cvy7/ExpressLRS/PCB/900MHz/RX30dbm_20x20_0805_SMD/README.md

# 20x38 RX30dbm PCB

  

## Features

 * 20x38 footprint
 * 0805 size SMD components (for easy soldering) - NOTE: LED is still 0603 as this size is more common in LEDs
 * Components are placed for ease of soldering (easy iron access)
 * u.fl antenna connector footprint for 915MHz antenna
 * PCB trace antenna for WiFi
 * 5V input 
 * RFM95PW-868S2 with Output power +27dBm

## Editing

 * The PCB has been developed in Eagle, and the custom libraries that were used are attached in the /lib directory. Copy the project files into you Eagle project dir, and the libs into your lib dir, then fire up Eagle and edit.

 ## Ordering

 * I've had good results using JLCPCB (https://jlcpcb.com/). Upload the .zip file in this repo and adjust any PCB parameters that you want (defaults work fine).
 * A super-lightweight build can be achieved by going to a 0.6mm PCB thickness (without an increase to cost)
