cvy7/ExpressLRS/PCB/900MHz/RX30dbm_20x20_0805_SMD/BOM.xlsx

Designator | Footprint | Value | Description | Link
u.fl | u.fl |  | u.fl antenna connector | https://au.rs-online.com/web/p/ufl-connectors/1440895/
button | 3x6x2.5 |  | Tactile button | https://www.ebay.com.au/itm/10pcs-3-6-2-5mm-Tactile-Push-Button-Switch-Tact-Switch-Micro-Switch-2-Pin-SMD/282930653324
D1 | 0603 |  | LED
RFM96PW |  |  | RF module | https://www.aliexpress.com/item/32811523237.html
C1 | 3528 | 10uF | Tantalum Capacitor
C2 | 3528 | 100uF | Tantalum Capacitor
R1 | 0805 | 10K | Resistor
R2 | 0805 | 10K | Resistor
R3 | 0805 | 330R | Resistor
R4 | 0805 | 270R | Resistor
 | SOT22 | AMS1117 3.3 | 3.3V reg | https://www.aliexpress.com/item/32910803907.html?s=p
ESP-01F |  |  | ESP8266 module | https://www.aliexpress.com/item/32921798906.html
