cvy7/ExpressLRS/PCB/900MHz/RX30dbm_20x20_0805_SMD/project/rx_bot.pdf

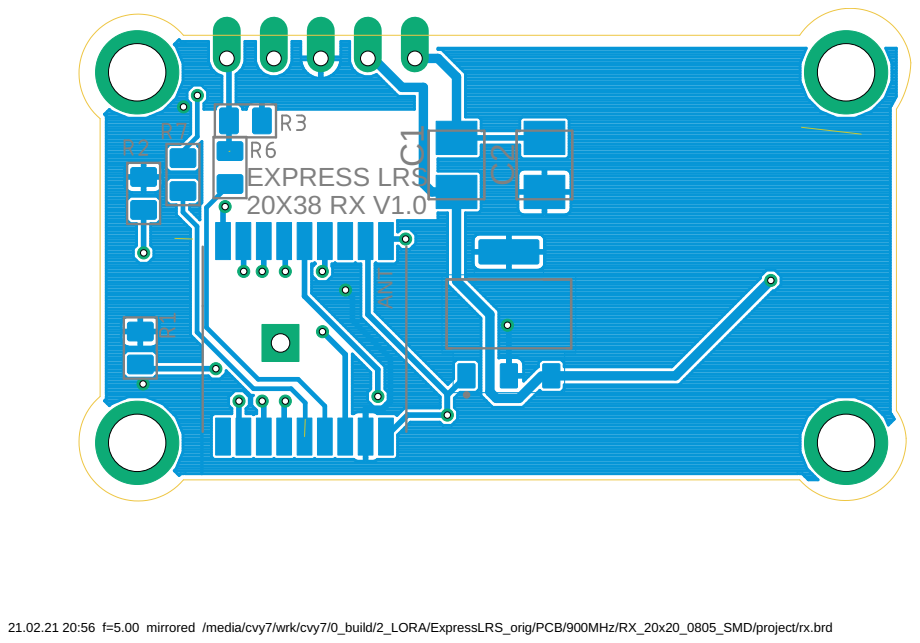
[picture p2: page 1]

21.02.21 20:56 f=5.00 mirrored /media/cvy7/wrk/cvy7/0_build/2_LORA/ExpressLRS_orig/PCB/900MHz/RX_20x20_0805_SMD/project/rx.brd
