cvy7/ExpressLRS/PCB/900MHz/RX30dbm_20x20_0805_SMD/project/rx_sh.pdf

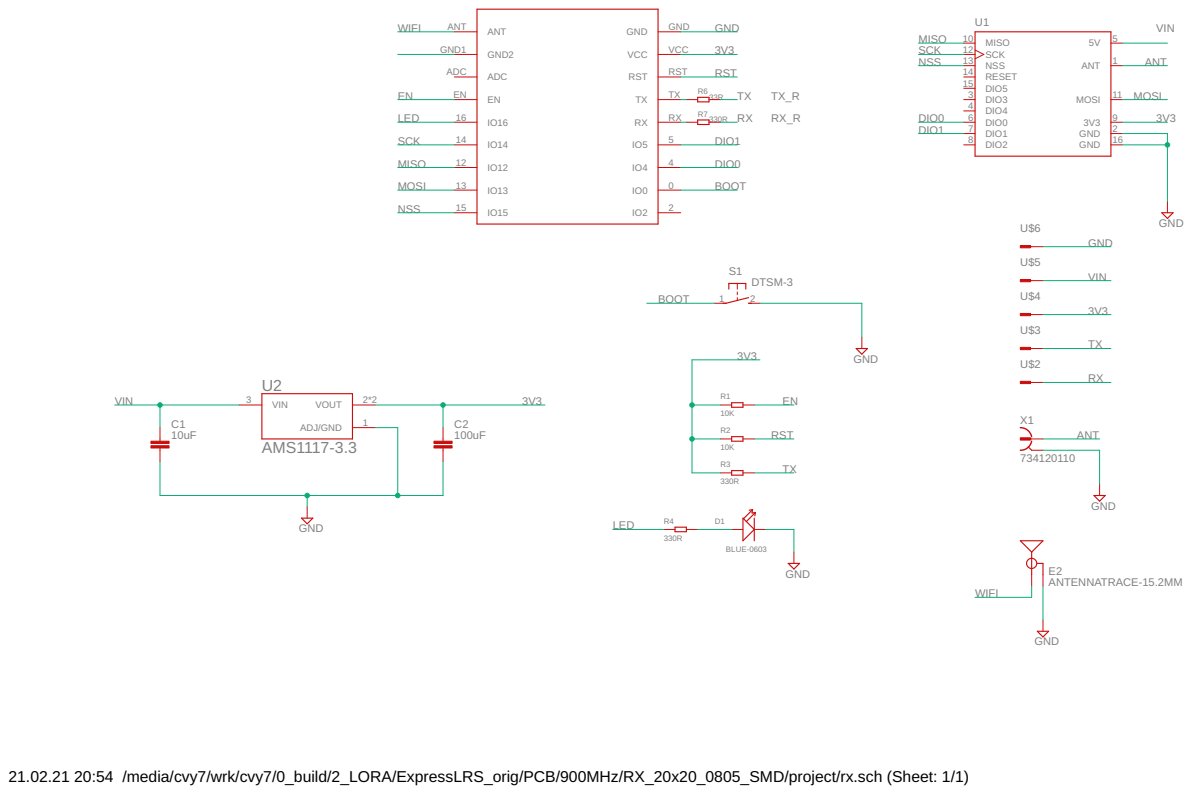
[picture p3: page 1]

21.02.21 20:54 /media/cvy7/wrk/cvy7/0_build/2_LORA/ExpressLRS_orig/PCB/900MHz/RX_20x20_0805_SMD/project/rx.sch (Sheet: 1/1)
