cvy7/ExpressLRS/PCB/900MHz/RX30dbm_20x20_0805_SMD/project/rx.brd

## EAGLE design PCB/900MHz/RX30dbm_20x20_0805_SMD/project/rx.brd (2021-02-21)

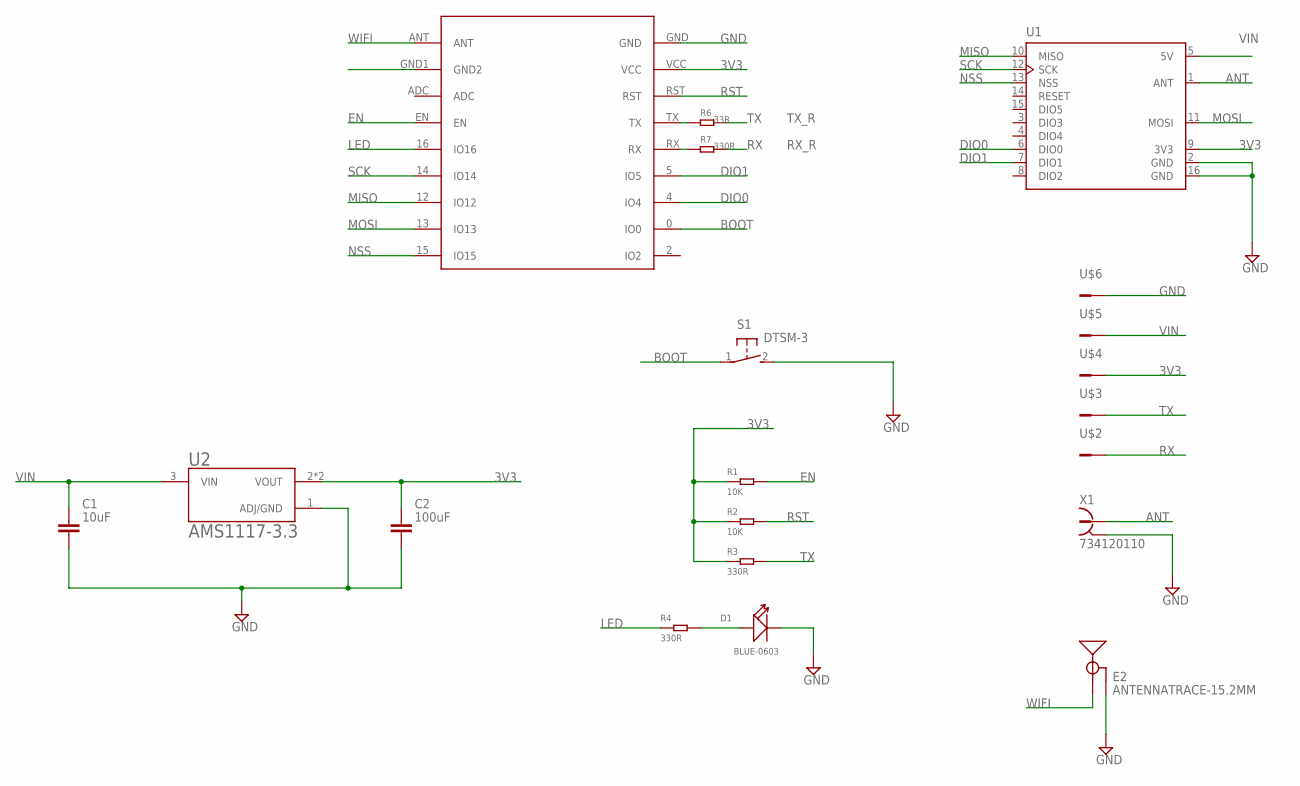
[picture p5: schematic rx.sch]

Parts:
C1: 10uF; CAPM3528X210
C2: 100uF; CAPM3528X210
D1: BLUE-0603; LED-0603
E2: ANTENNATRACE-15.2MM; TRACE_ANTENNA_2.4GHZ_15.2MM
R1, R2: 10K; R0805
R3, R4, R7: 330R; R0805
R6: 33R; R0805
S1: DTSM-3
U1: RFM95PW-868S2PW; XCVR_RFM95PW-868S2
U2: AMS1117-3.3; SOT229P700X180-4N
U$1: ESP-M2
U$2, U$3, U$4, U$5, U$6: CONN-1; PAD1
X1: 734120110

Connections:
3V3: C2.1, R1.1, R2.1, R3.1, U1.9 (3V3), U2.2 (VOUT), U2.4 (VOUT), U$1.VCC, U$4.P$1
ANT: U1.1 (ANT), X1.1
BOOT: S1.1, U$1.0 (IO0)
DIO0: U1.6 (DIO0), U$1.4 (IO4)
DIO1: U1.7 (DIO1), U$1.5 (IO5)
EN: R1.2, U$1.EN
GND: C1.2, C2.2, D1.-, E2.GND, S1.2, U1.2 (GND), U1.16 (GND), U2.1 (ADJ/GND), U$1.GND, U$1.GND1 (GND2), U$6.P$1, X1.S@1 (2), X1.S@2 (2), X1.S@3 (2)
LED: R4.1, U$1.16 (IO16)
MISO: U1.10 (MISO), U$1.12 (IO12)
MOSI: U1.11 (MOSI), U$1.13 (IO13)
unnamed: D1.+, R4.2
NSS: U1.13 (NSS), U$1.15 (IO15)
RST: R2.2, U$1.RST
RX: R7.2, U$2.P$1
RX_R: R7.1, U$1.RX
SCK: U1.12 (SCK), U$1.14 (IO14)
TX: R3.2, R6.2, U$3.P$1
TX_R: R6.1, U$1.TX
VIN: C1.1, U1.5 (5V), U2.3 (VIN), U$5.P$1
WIFI: E2.ANT (SIGNAL), U$1.ANT

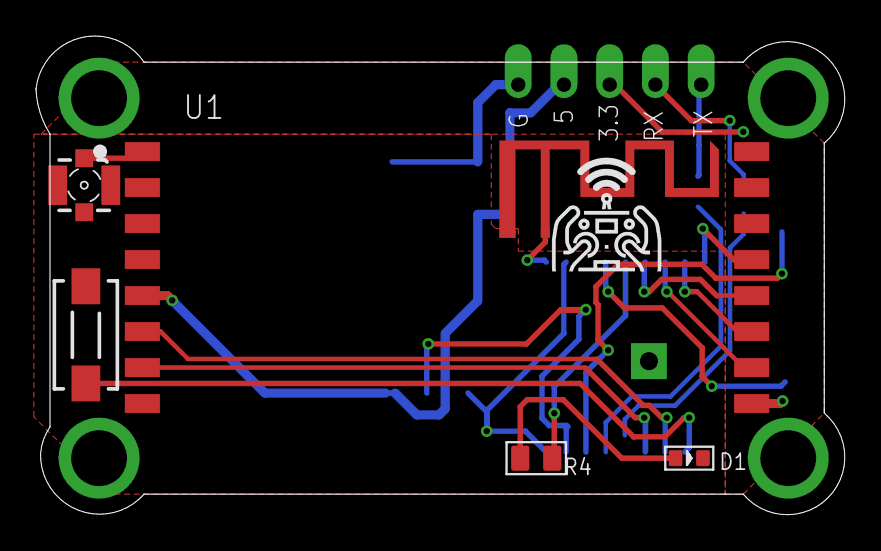
[picture p6: board rx.brd from above]

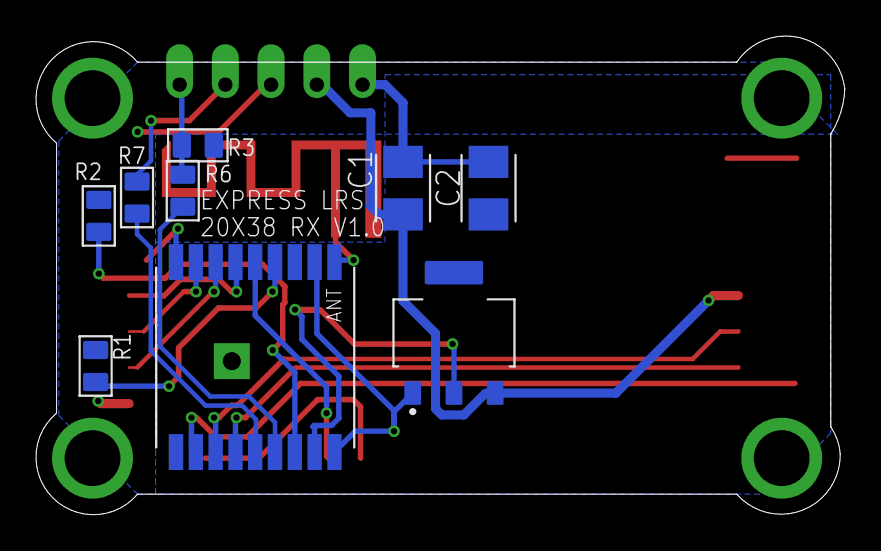
[picture p7: board rx.brd from below]

Board: 2 copper layers, 44.9 x 26.6 mm, 20 parts (9 on the bottom side), 20 nets.
